pisicaverde/yet-another-internet-radio/src/tools/README.md

* `beep_test`: just to check that VS1053 is wired correctly to ESP8266 and both are working fine
* `esp_23lc1024-1`: quick SRAM test
* `keyboardRead` : to calibrate the keyboard readings (values for AnalogIn)
