pisicaverde/yet-another-internet-radio/schematics.pdf

# Internet radio

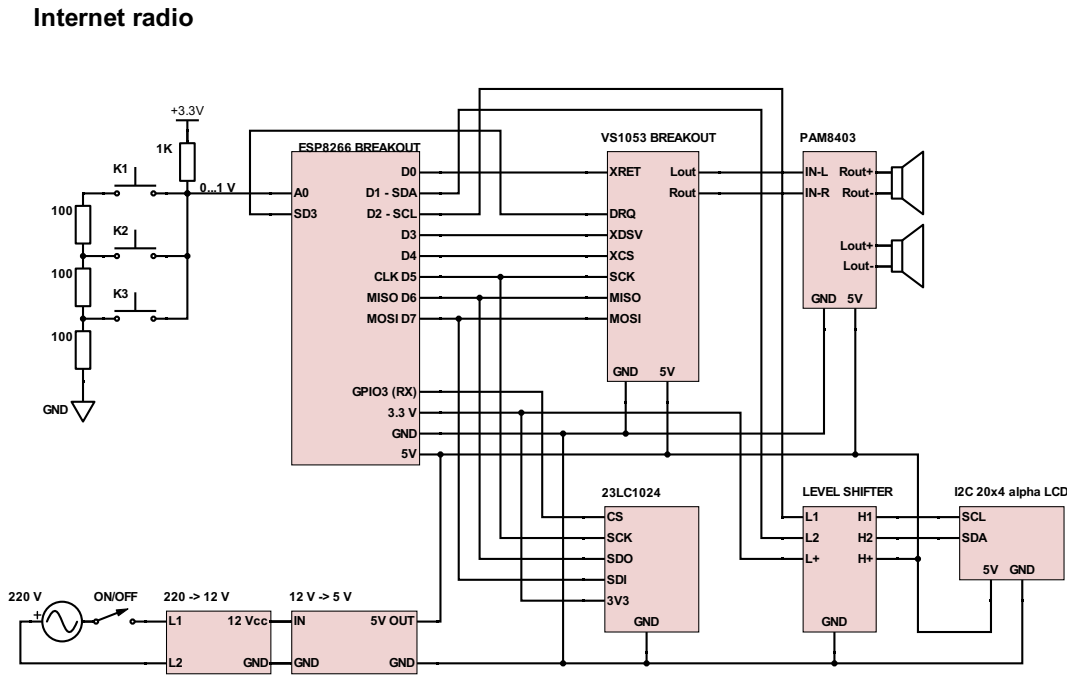
[picture p2: page 1]
