pisicaverde/yet-another-internet-radio/images/back panel print/panel-back-print.pdf

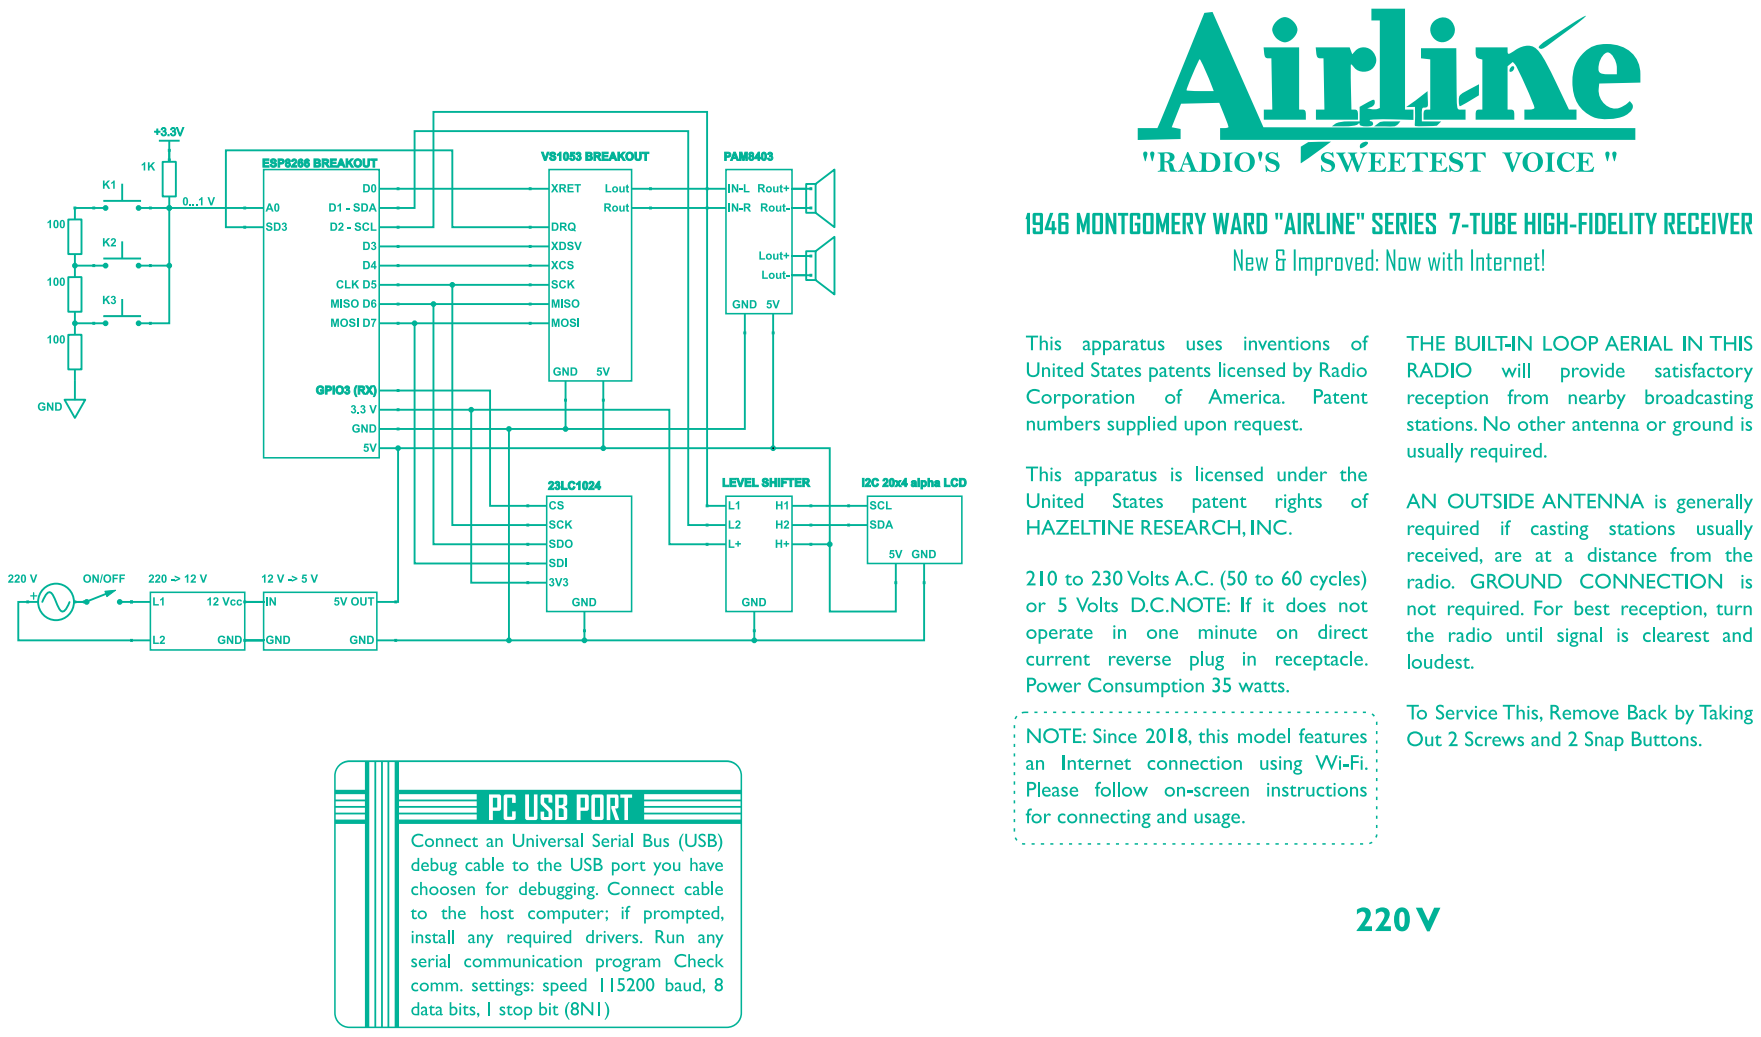
[picture p3: page 1]
