pisicaverde/yet-another-internet-radio/images/back panel print/panel-back-viewing.pdf

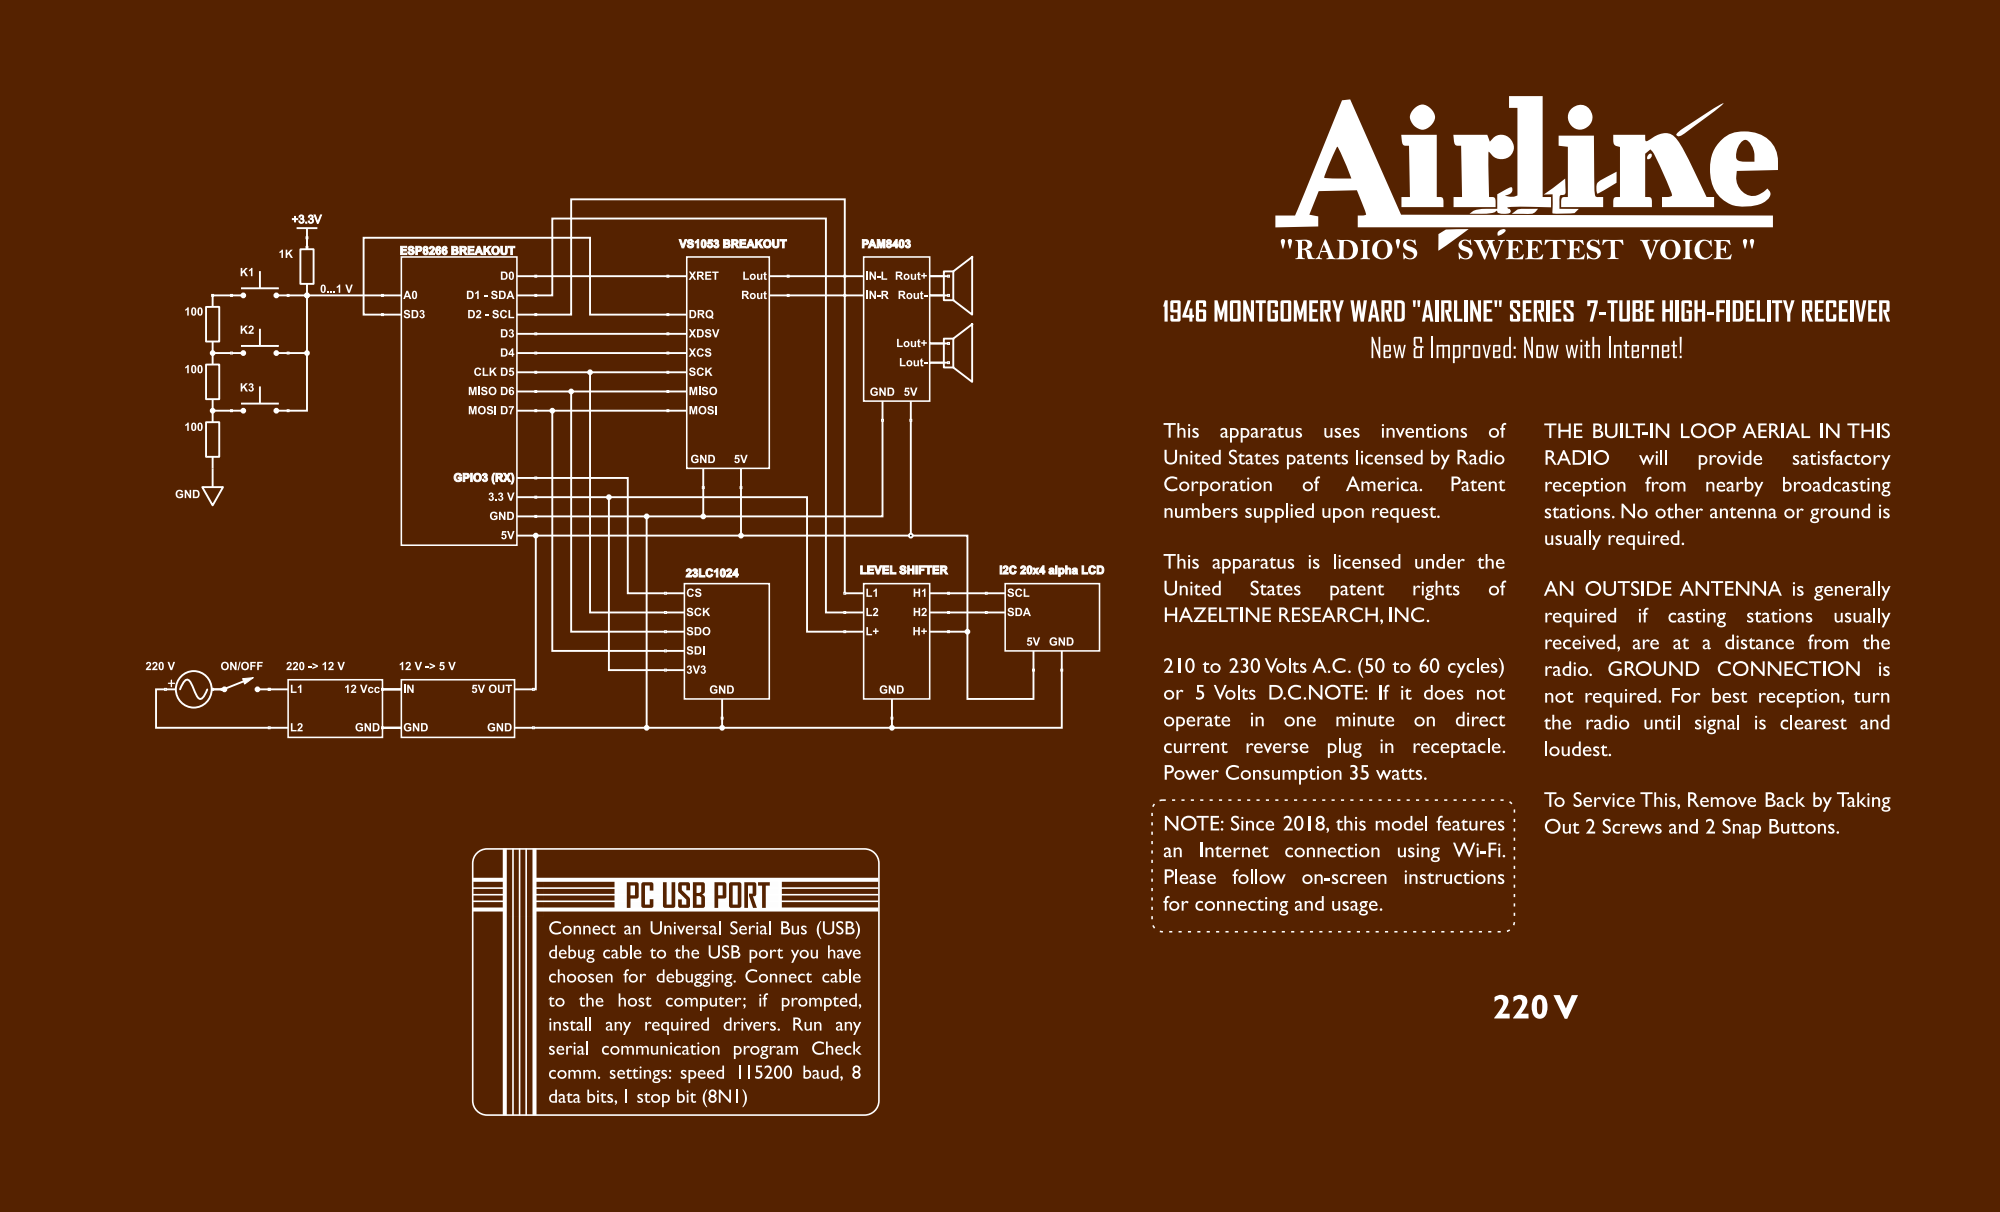
[picture p4: page 1]
