pisicaverde/yet-another-internet-radio/src/internet-radio/1mp3.ino

const PROGMEM byte static_mp3[] = {
    0xff, 0xe3, 0x18, 0xc4, 0x00, 0x07, 0xf8, 0x01, 0xd9, 0x70, 0x08, 0x44,     0x94, 0xcd, 0x7d, 0x52, 0x1a, 0xe9, 0xa0, 0x58, 0xce, 0x87, 0xed, 0x76, 
    0x6b, 0xf4, 0xf9, 0xbf, 0xe2, 0xc6, 0x3f, 0xbb, 0xff, 0xe9, 0x7f, 0xff,     0xf5, 0xa0, 0x23, 0xfc, 0x98, 0x11, 0xbf, 0xfa, 0x90, 0xb3, 0x43, 0x63, 
    0xf5, 0xb4, 0xdb, 0x31, 0xdc, 0x86, 0xcd, 0xc9, 0xbf, 0x39, 0xa3, 0xe7,     0x00, 0xff, 0xd3, 0x4f, 0xe7, 0x3f, 0x21, 0x7f, 0xff, 0xf5, 0x1c, 0x2e, 
    0xff, 0xe3, 0x18, 0xc4, 0x1b, 0x08, 0xb0, 0x06, 0x66, 0xf8, 0x00, 0x44,     0x00, 0xfa, 0xff, 0xd3, 0xff, 0xf6, 0x75, 0x3b, 0xa6, 0x99, 0xa5, 0x29, 
    0x3c, 0x76, 0x25, 0x9f, 0xcb, 0x67, 0x66, 0x62, 0x18, 0x78, 0x76, 0xf3,     0x94, 0xa4, 0xd2, 0x97, 0xbd, 0xe6, 0x66, 0x6e, 0xbc, 0x48, 0x12, 0x0f, 
    0x13, 0x88, 0x60, 0x0e, 0x06, 0xcb, 0x80, 0x40, 0x3f, 0x0e, 0x06, 0x02,     0x5a, 0x13, 0xaf, 0xd2, 0x6f, 0x7b, 0xcc, 0xe5, 0x29, 0xd9, 0x46, 0x1c, 
    0xff, 0xe3, 0x18, 0xc4, 0x33, 0x15, 0xe9, 0xde, 0x8c, 0x00, 0x03, 0x0a,     0x3c, 0xd3, 0xb5, 0xfe, 0x43, 0x88, 0x0a, 0x09, 0x8f, 0x0e, 0x7f, 0xd4, 
    0xf3, 0xbf, 0xff, 0x57, 0x14, 0x13, 0x16, 0x03, 0x87, 0x04, 0xc0, 0x3a,     0x79, 0x01, 0x01, 0x70, 0x22, 0x59, 0x08, 0x00, 0xff, 0xff, 0xff, 0x91, 
    0x1b, 0x7d, 0xfd, 0x56, 0xb1, 0xae, 0x60, 0x04, 0x7d, 0xee, 0x13, 0xa5,     0xff, 0x9a, 0x6b, 0x11, 0x17, 0x0d, 0xa4, 0x86, 0xc3, 0x51, 0x20, 0x02, 
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
    0x1a, 0x4c, 0x41, 0x4d, 0x45, 0x33, 0x2e, 0x39, 0x39, 0x2e, 0x35, 0x55,     0x55, 0x55, 0x55, 0x55, 0x55, 0x55, 0x55, 0x55, 0x55, 0x55, 0x55, 0x55 };
