pisicaverde/yet-another-internet-radio/src/internet-radio/PROGMEM_readAnything.h

template <typename T> void PROGMEM_readAnything (const T * sce, T& dest)
  {
  memcpy_P (&dest, sce, sizeof (T));
  }

template <typename T> T PROGMEM_getAnything (const T * sce)
  {
  static T temp;
  memcpy_P (&temp, sce, sizeof (T));
  return temp;
  }  
